franciscds/ProjetoLab3/RelatorioFinalLABPROJ03.pdf

Relatorio de Projeto - Rob ´ | o Aut ˆ | onomo ˆ

Breno Augusto Mariano, Bruno Pena Modesto e Francis Carlos Santos

I. RESUMO
Este trabalho objetiva a concepçao, construç ˜ | ao e teste de ˜
um Robo na forma de um chassi para reconhecimento da ˆ
localizaçao de blocos e sua posterior movimentaç ˜ | ao para ˜
outra determinada regiao. O principal desafio deste projeto ˜ | é
implementar um software necessario para que um rob ´ | o possa ˆ
ser capaz de receber informaçoes de sua localizaç ˜ | ao e de ˜
obstaculos via ´ | bluetooth e desempenhar algumas tarefas pre-´
estabelecidas a partir das informaçoes recebidas. ˜

II. INTRODUÇ AÕ

Durante a disciplina de Laboratorio de Projetos 3 foi pro- ´
posto a elaboraçao de um projeto para a criaç ˜ | ao de um rob ˜ | ô
que moveria alguns corpos (blocos) para regioes previamente ˜
especificadas. Para realizar tal missao, ˜ | e necess ´ | ario um soft- ´
ware adequado para que o robo possa desempenhar essas ati- ˆ vidades. O software desenvolvido possui uma parte destinada
as configuraçoes de comunicaç ˜ | ao fornecidas pelo professor, ˜
uma parte para teste da comunicaçao via ˜ | bluetooth e uma
parte destinada ao controle do robo durante seu deslocamento. ˆ
Na seçao Materiais e M ˜ | etodos ser ´ | a mostrado os materiais ´
que foram utilizados no projeto. Nas seçoes de Projeto da ˜ Parte de Software para Comunicaçao e Projeto da Parte de ˜
Software para Controle serao descritas e detalhadas as decis ˜ | oes ˜
de implementaçao que foram tomadas no projeto havendo uma ˜
discussao e justificativa sobre o porqu ˜ | e de cada escolha ter ˆ
sido realizada. As motivaçoes que iniciaram esse estudo sobre ˜
essa tecnologia de veículos autonomos s ˆ | ao expostas a seguir. ˜
A principal vantagem dos carros autonomos ˆ | e justamente de ´
nao cometerem os mesmos erros de um condutor humano, ˜
tais quais: conduçao ego ˜ | ísta, lentidao de reflexos, violaç ˜ | ao de ˜
normas de segurança, sono e embriaguez. Os carros autonomos ˆ podem inclusive superar o reflexo normal humano, prevendo
provaveis acidentes em sua trajet ´ | | oria []c2. Plataformas de ´
transporte de pessoas em veículos privados, como a Uber, naõ funcionam com um frota de veículos de forma contínua devido
a limitaçao humana do condutor. Com ve ˜ | ículos autonomos, ˆ
uma menor frota de carros poderia atender de igual forma
o mesmo numero de usu ´ | arios do aplicativo, sem que seja ´
necessario ter gastos adicionais por trabalho noturno ou du- ´ rante finais de semana e feriados. Alem disso, outro ponto ´
interessante ao usuario ´ | e a quest ´ | ao da privacidade, j ˜ | a que ´
ao se retirar o condutor humano do veículo, o cliente poderá
sentir-se mais confortavel durante seu transporte. H ´ | a tamb ´ | em´
o fator de melhoria de segurança do serviço, pois conforme testes realizados pelo Google em seus veículos autonomos ˆ []c1, o fator humano pode ser considerado como a principal causa de acidentes envolvendo carros autonomos; por exemplo, ˆ houveram acidentes principalmente por culpa de condutores humanos de outros veículos convencionais []c3.

III. MATERIAIS E METODOS ´

Todos os materiais utilizados ao longo do projeto foram listados abaixo. Lista de Materiais:
- 1 Protoboard;
- 2 conjuntos (Roda de Traçao + Motor); ˜
- 1 Modulo Receptor Bluetooth; ´
- 1 Arduíno Uno;
- 1 Roda Boba;
- 1 Ponte H;
- Palitos de madeira e cola;
- 1 Bateria 9V;
- 2 Leds vermelho;
- 2 Resistores de 150 ohm, 330 ohm e 660 ohm;
- Software de Programaçao Arduino; ˜
- Aplicativo Android Bluetooth SPP Pro.

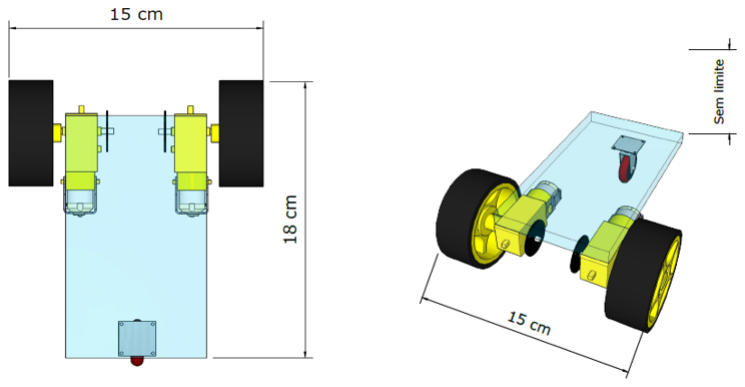
[picture p1: figure]

Figura 1: desenho inicial do robo e suas dimens ˆ | oes m ˜ | aximas ´
permitidas

Especificaçao dos Motores e das Rodas: ˜
- Tensao de Operaç ˜ | ao: 3-6 V; ˜
- Taxa de Reduçao 48:1; ˜
- Peso:30 gramas;
- Corrente sem carga: ate 200 mA(6V) e at ´ | e 150 mA(3V); ´
- Velocidade sem carga: 200 RPM (6V) e 90 RPM (3V);
- Diametro: 6.8 cm ; ˆ
- Largura: 2.6 cm;
- Furo central: 5.3 x 3.66 mm (semi-círculo);
- Peso:50 gramas.
| IV. PROJETO PARTE MECANICA E ˆ | ELETRONICA ˆ
Na figura Figura 2 ha a estrutura principal do rob ´ | o, feita de ˆ
palitos de madeira. Ha dois conjuntos roda e motor el ´ | etrico, ´
alem de uma roda boba na parte frontal do chassi dando ao ´
robo estabilidade lateral. Na parte superior est ˆ | ao alocados os ˜
demais componentes especificados na lista de materiais. Eles
serao respons ˜ | aveis pelo controle do rob ´ | o juntamente com a ˆ
funçao de comunicaç ˜ | ao dos dados de operaç ˜ | ao do rob ˜ | o. Ser ˆ | á
utilizado um padrao de identificaç ˜ | ao via ˜ | Bluetooth (QR code)

na parte superior dos blocos e do robo. Um sistema exterior ˆ
e de responsabilidade do Cliente fara a leitura da localizaç ´ | aõ
atual do bloco e das coordenadas de sua alocaçao futura, trans- ˜
mitindo tais informaçoes para o rob ˜ | o. O sistema embarcado do ˆ
robo interpretar ˆ | a os dados recebidos e controlar ´ | a o rob ´ | o para ˆ
realizar a movimentaçao. A explicaç ˜ | ao detalhada da funç ˜ | ao de ˜
cada componente esta presente na seç ´ | ao de projeto mec ˜ | anico ˆ
e eletronico desse relat ˆ | orio. A ideia inicial de desenho do rob ´ | ô
foi baseada na proposta mostrada pelo Professor-Orientador, a qual encontra-se na figura Figura 1 , juntamente com suas dimensoes m ˜ aximas permitidas. ´
V. PROJETO DA PARTE MECANICA ˆ
O desenho do robo em uma vista isom ˆ | etrica para uma ´
melhor perspectiva e mostrado na figura Figura 2, todos os de- ´ senhos foram feitos na plataforma SketchUp, para atender uma
restriçao de projeto de utilizaç ˜ | ao de ferramentas e plataformas ˜
abertas: O objetivo principal que norteou o novo desenho do

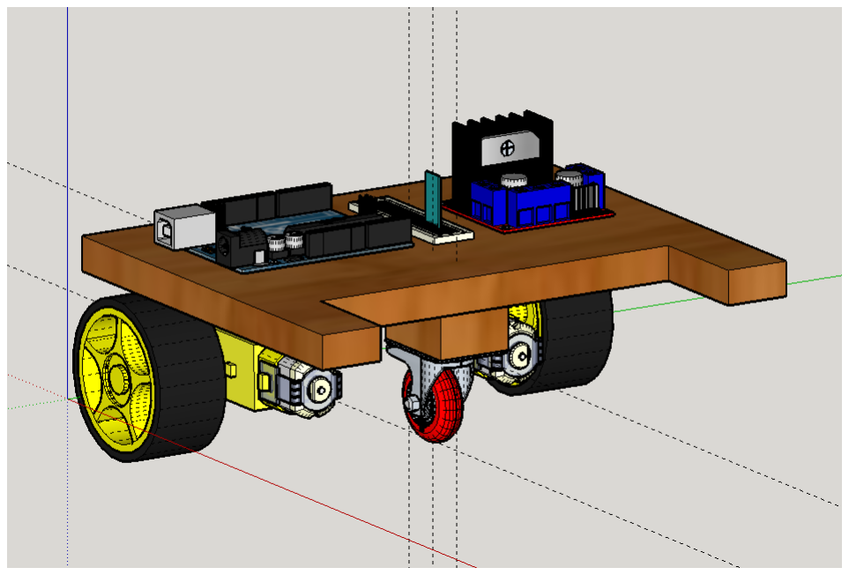
[picture p2: figure]

Figura 2: Vista isometrica do rob ´ | ô
chassi proposto foi a estabilizaçao e posterior movimentaç ˜ | aõ
do bloco, para isso foi criada duas “garras” na parte frontal do chassi, entre as quais serao alocados os blocos e em seguida ˜
sera iniciado a sua operaç ´ | ao de movimentaç ˜ | ao. O tamanho ˜
das garras foi projetado para se manter o centro de massa, e consequentemente o centro geometrico ( considerando que ´
o bloco e uniforme, esses dois pontos s ´ | | ao coincidentes) do ˜
bloco estavel durante o seu deslocamento. ´ | E preciso ressaltar ´
que os fios eletricos ir ´ | ao contornar o chassi e ser ˜ | ao fixados ˜
com adesivos para nao haver qualquer tipo de deslocamento ˜
dos mesmos, podendo atrapalhar a dinamica de movimentaç ˆ | aõ
do robo. A soluç ˆ | ao inicial de perfuraç ˜ | ao de um orif ˜ | ício
no chassi principal do robo foi descatada tendo em vista a ˆ
manutençao da estrutura inicial do chassi do rob ˜ | o, j ˆ a que uma ´
perfuraçao acarretaria no surgimento de pontos concentradores ˜ de tensao, os quais poderiam evoluir para trincas ou micro- ˜ rupturas, danificando a estrutura do chassi; alem do fato ´
de a soluçao adotada ser de implementaç ˜ | ao mais simples. ˜
Conforme e poss ´ | ível averiguar na Figura 1 que mostra os
tamanhos maximos estabelecidos para o rob ´ | o, somente duas ˆ
dimensoes foram limitadas. Assim, a terceira dimens ˜ | ao (altura ˜
do robo) foi utilizada para alocar todos os componentes. A ˆ figura Figura 3 com melhor detalhes a disposiçao das rodas ˜
do robo. Baseado na estrat ˆ | egia de utilizaç ´ | ao da dimens ˜ | ao n ˜ | ao- ˜

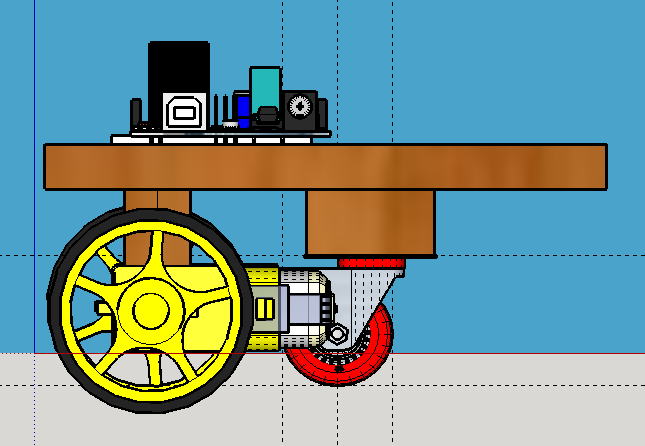
[picture p3: figure]

Figura 3: vista lateral do robo com destaque para as rodas ˆ

limitada do robo, optou-se pela colocaç ˆ | ao de suportes fixados ˜
nos motores para aumentar a altura do chassi principal em
relaçaõ as rodas de traç ` | ao (rodas amarelas), impedindo que ˜
haja contato físico entre o chassi e essas rodas, o que poderia danificar o chassi, prejudicar a rotaçao das rodas e impedir o ˜
funcionamento correto do robo. Foi adicionado tamb ˆ | em um ´
suporte para a roda boba, de forma a nivelar o chassi.

VI. PARTE ELETRONICA ˆ

Sera usada uma bateria de 9V para alimentar o circuito. A ´ bateria foi selecionada por ser mais compacta para a monta-
gem; alem de os participantes do projetos j ´ | a possu ´ | írem e terem
conhecimento previo sobre esse componente. Uma ligaç ´ | | ao em ˜
paralelo sera feita para utilizar a mesma bateria, alimentando ´ ambos os componentes. Embora o arduíno necessite de 5V de
tensao na entrada, o circuito ˜ | e preparado internamente com ´
um divisor de tensao, ou seja, qualquer tens ˜ | ao al ˜ | em dos 5V ´
sera dissipada. A Figura 4 mostra o esquema de ligaç ´ | | ao dos ˜
componentes eletronicos. ˆ

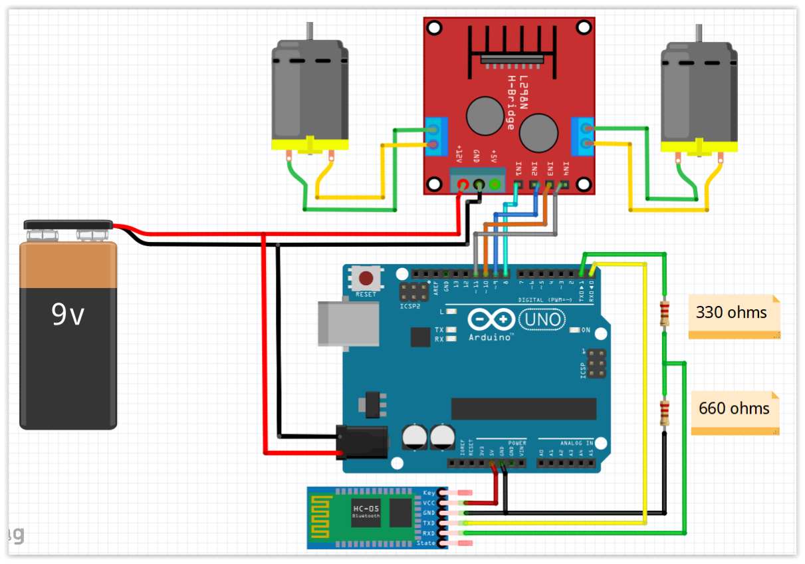
[picture p4: figure]

Figura 4: Esquematico de montagem dos componentes ´
eletronicos b ˆ | asicos do carrinho ´

A seguir descreve-se a disposiçao proposta dos componentes ˜
e o motivo de sua utilizaçao. A ponte H (Figura 5) ˜ | e um ´
circuito que permite realizar a inversao da polaridade da ˜
corrente que flui atraves de uma carga, por isso ´ | e interessante ´
para controlar os motores DC.

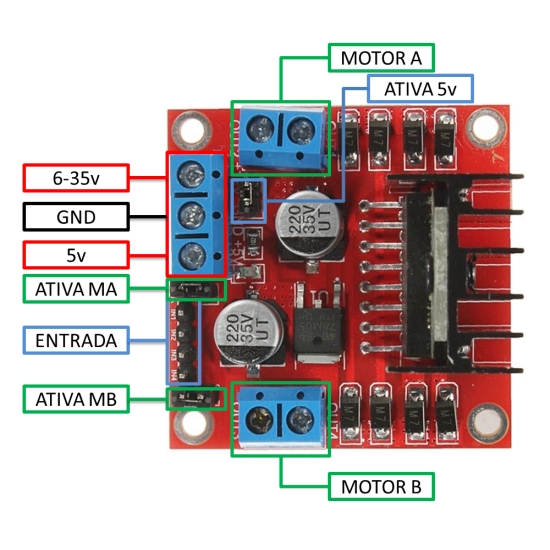
[picture p5: figure]

Figura 5: Ponte H com indicaçao de pinos ˜

A Figura 5, mostra a ponte H e suas entradas. A ponte H pode ser alimentada de 2 formas, com tensao de 5V, no caso ˜
de ligaçao direta do arduino e ˜ | 6-35V para alimentaçao externa. ˜
Para utilizar a alimentaçao de 5V, o jumper em ˜ | Ativa 5V deve
ser removido para configurar uma referencia na entrada de ˆ | 6-
35V. Ativa MA corresponde ao motor A e Ativa MB a ativaç ` | aõ
do nível logico para o ´ | motor B, para nosso projeto nenhum
jumper foi removido. O arduíno foi o micro-controlador escolhido, o qual transmitira para as rodas as coordenadas que ´
serao informadas pelo dispositivo ˜ | bluetooth. O arduíno passará
instruçoes para os motores por meio das entradas ˜ | PWM (
modelagem por largura de pulso) de numeros 4,5,6 7, 2 e ´
3. As portas 4,5,6 e 7 serao utilizadas para dar sentido para ˜
o movimento e as portas 2 e 3 serao a alimentaç ˜ | aõ PWM na
entrada de enable na ponte H dessa forma variando a tensaõ
de ativaçao das rodas simulando v ˜ | arios ´ | pings de 0 a 5 volts.
A utilizaçao das portas ˜ | PWM possibilita que a velocidade de
rotaçao dos motores seja controlada e n ˜ | ao uma constante. O ˜
Arduíno Uno foi escolhido por sua implementaçao ser mais ˜ simples, por exemplo a possibilidade de se realizar a sua carga
diretamente do computador e tambem pela experi ´ | encia pr ˆ | evia ´
dos participantes do projeto com tal dispositivo.
O modulo ´ | Bluetooth escolhido foi o modelo HC-06 que
possui 4 pinos (alimentaçao, ˜ | GND,RX e TX). Os dois ultimos ´
sao utilizados para comunicaç ˜ | ao com o micro-controlador ˜
via serial. O nível logico dos pinos ´ | RX e TX e 3.3V, logo ´
precisamos de um divisor de tensao no pino ˜ | RX para que
esse nao seja danificado. Esses pinos ser ˜ | ao ligados na entrada ˜
serial do Arduino Uno que possui um par 0(RX) e 1(TX).
A utilizaçao do m ˜ | odulo ´ | Bluetooth deve-se ao processo de
recebimento das coordenadas de localizaçao do rob ˜ | o atrav ˆ | es´
de um marcador QR-code, esse sinal sera transmintido atrav ´ | es´
de um dispositivo bluetooth. O modelo HC-06 foi escolhido
por ter a implementaçao mais simples, a sua desvantagem ˜ | é
a restriçao em somente receber dados. O ardu ˜ | íno foi ligado
em paralelo a bateria de 9V. O nível logico do arduino ´ | e de ´
5V e a sua capacidade de entrada e de 3.3V, para n ´ | ao haver ˜
nenhum dano foi montado um divisor de tensao utilizando dois ˜
resistores, projetando uma tensao m ˜ | axima de 3.3V no pino ´ | RX.

VII. PROJETO DA PARTE DE SOFTWARE PARA COMUNICAÇ AÕ
A parte de software estabelecida para o projeto consiste de 3 codigos que foram utilizados para fazer um teste inicial de ´
comunicaçao via ˜ | bluetooth com smartphone, outro para testar
a recepçao dos dados recebidos do sistema de localizaç ˜ | | | | | | | ao e por ˜
ultimo um c ´ | odigo respons ´ | avel para receber e tratar os dados ´
recebidos para serem utilizados para o controle do carrinho.
Em todos os codigos, dentro do procedimento ´ | setup, e definido ´
inicialmente uma comunicaçao serial via ˜ | bluetooth e atraves´
de quais pinos do arduíno ela ocorre. Em todos os codigos ´ a comunicaçaõ bluetooth recebeu o nome de mySerial. Para
implementaçao do c ˜ | odigo foi utilizado o software do ardu ´ | íno,
escrito predominantemente em C++.
Apos | a | configuraç ´ | ao | do | m ˜ | odulo ´ | bluetooth | para
comunicaçao, foi implementado um c ˜ | odigo para testar a ´
comunicaçao. Esse c ˜ | odigo realiza inicialmente um comando ´
(if(mySerial.available() > 0)) para verificar se a comunicaçaõ bluetooth esta estabelecida, depois de o ser teste realizado, foi ´ utilizado o aplicativo android Bluetooth SPP Pro para enviar as letras A e B para o arduíno, dependendo da letra recebida, um led era aceso e em caso de outra letra recebida, outro led era aceso e nos dois casos uma mensagem de confirmaçaõ era retornada para o smartphone.
O codigo utilizado para testar o recebimento dos dados en- ´ viados pelo sistema e verificar o formato dos dados recebidos,
faz um teste inicial da comunicaçao atrav ˜ | es dos comandos ´
if(mySerial.available() > 0) e if(Serial.available() > 0)), para verificar sua integridade, caso a comunicaçao esteja ˜ estabelecida, as mensagens recebidas do sistema de localizaçaõ
via bluetooth sao passadas para o ardu ˜ | íno atraves do comando ´
(mySerial.write(Serial.read()) que esta dentro do ´ | if que avalia
a comunicaçao serial) s ˜ | ao escritas na sa ˜ | ída (monitor serial do
arduíno) utilizando o comando (Serial.write(mySerial.read())
que esta dentro do if que avalia a comunicaç ´ | aõ mySerial),
os dados sao mostrados conforme recebidos, sem nenhum ˜ tratamento.
A parte de recebimento e manipulaçao da informaç ˜ | ao, ˜
basicamente (em alto nível) armazena a mensagem recebida,
caracter por car ´ | acter, e depois separa a informaç ´ | ao de acordo ˜
com o seu destino. Assim, caso a mensagem se refira ao nosso carrinho (letra C como identificador), sua posiçao nos ˜
eixos cartesianos x-y e o angulo em relaç ˆ | ao a refer ˜ | encia ˆ
serao salvos em tr ˜ | es vari ˆ | aveis. Caso a mensagem se refira ´
a algum outro carrinho ou obstaculo (letras A, B, D ou E), ´
as informaçoes ser ˜ | ao armazenadas em outras tr ˜ | es vari ˆ | aveis. ´
A tarefa desempenhada por esse codigo pode ser melhor ´ representada por um fluxograma, conforme Figura 6 abaixo:

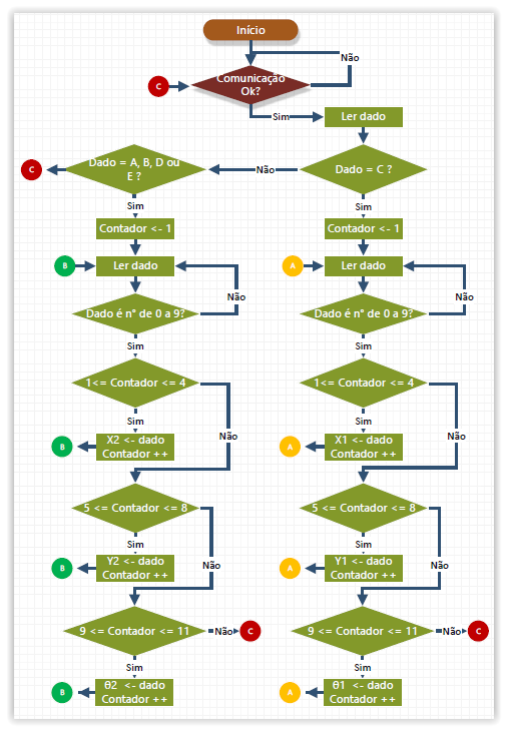
[picture p6: figure]

Figura 6: Fluxograma de Recepçao dos Dados ˜

Na Figura 6 as variaveis X ´ | 1, Y1, X2 e Y2 sao vetores de ˜
tamanho 4 e as variaveis ´ | | θ1 e θ2 sao vetores de tamanho 3. ˜
Os dados recebidos sao do tipo ˜ | char e sao manipulados dessa ˜
forma, apos a separaç ´ | ao eles s ˜ | ao convertidos para inteiro para ˜
que sejam utilizados em calculos matem ´ | aticos. O fluxograma ´
mostra como e feito o recebimento e manipulaç ´ | ao para dois ˜
marcadores (carrinhos ou obstaculos), caso em uma aplicaç ´ | aõ
exista mais marcadores, o mesmo codigo implementado base- ´ ado no fluxograma pode ser reutilizado com poucas alteraçoes, ˜
incluindo novas variaveis X’n°’, Y’n°’ e ´ | θ’n°’ para cada
marcador adicional.

VIII. PROJETO DA PARTE DE SOFTWARE PARA CONTROLE

A. Príncipios físicos e modelagem
A definiçao do modelo cinem ˜ | atico ´ | e de extrema import ´ | ancia ˆ
para a definiçao do sistema de controle. Pois ele determina as ˜
equaçoes que conduzem a din ˜ | amica de movimentaç ˆ | ao do rob ˜ | o. ˆ
Na figura Figura 7 pode-se observar esse modelo.
Esse modelo pode ser representado, pelas seguintes equaçoes: ˜

dx
dt =
| Ve + Vd | cosθ

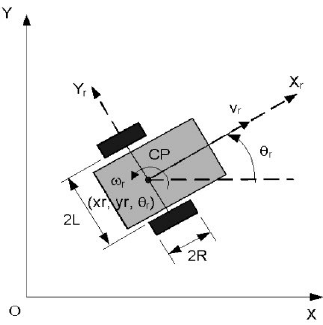
[picture p7: figure]

Figura 7: Modelo cinem´ atico do Modelo ´

dy
dt =

Ve + Vd
2

sinθ

dθ
dt =

Ve − Vd
2
A distancia de refer ˆ | encia para partida ser ˆ | a calculada atrav ´ | es´
da formula de dist ´ | ancia Euclidiana mostrada abaixo: ˆ
| d =

p
| (xk+1 − x) | 2 + (yk+1 − y)

2

B. Projeto de Controlador
O controlador foi implementado utilizando a logica ´ fuzzy. O controlador fuzzy pode controlar a navegaçao e evitar, ˜
simultaneamente, os obstaculos. A estrutura b ´ | asica do pro- ´
jeto contem tr ´ | es partes principais: fuzzificaç ˆ | ao, infer ˜ | encia e ˆ
desfuzzificaçao. A primeira etapa ˜ | e a fuzzificaç ´ | ao que trans- ˜
forma os dados de entrada reais em funçoes de pertin ˜ | encia ˆ
classificadas por magnitude. A segunda parte e a infer ´ | encia ˆ
da saída fazendo-se uma analise das entradas comparando- ´ as com as regras pre-definidas. No caso deste trabalho como ´ teremos mais de uma entrada a regra de decisao ser ˜ a do tipo: ´

IF(CONDICAO1)T HEN(CONCLUSAO)

Por ultimo ser ´ | a realizada a desfuzzificaç ´ | ao que ˜ | e o processo ´
de se retirar resultados numericos da funç ´ | ao de pertin ˜ | encia de ˆ
saída baseada nas saída da segunda etapa.
No Matlab o processo pode ser criado atraves do ´ plugin mostrado abaixo na Figura Figura 8. Porem, com o intuito ´ de desenvolver o controlador ferramentas Open Source foi decidido implementar a logica ´ fuzzy diretamente no arduino utilizando a biblioteca eFLL - Embebed Fuzzy Logic Library.

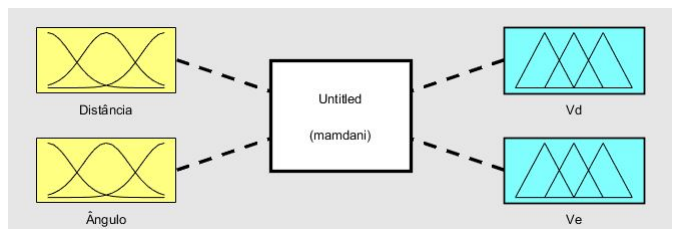
[picture p8: figure]

Figura 8: Diagrama Fuzzy

C. Biblioteca Utilizada
Para implementar a logica ´ fuzzy no arduíno, existe a biblioteca Embebed Fuzzy Logic Library sendo toda desenvolvida utilizando apenas a biblioteca stdlib.h, logo e uma biblioteca ´ que pode ser usada em qualquer sistema que suporte a linguagem C []c4. Os compomentes principais dessa biblioteca sao: ˜
- Objeto Fuzzy: Objeto que engloba todo o sistema fuzzy, com ele podemos manipular todos os conjuntos fuzzy e
suas variaveis lingu ´ | ísticas.
- Objeto | FuzzyInput: | Representaçao | da | vari ˜ | avel ´
linguística de entrada do sistema. E bastante similar a ´
variavel criada para a sa ´ | | ída do sistema.
- Objeto FuzzySet: E utilizado para a modelagem da ´
funçao de pertin ˜ | encia de uma vari ˆ | avel. As funç ´ | oes podem ˜
ser triangulares, trapezoiais e singleton.
- Objeto FuzzyOutput: Da mesma forma que o FuzzyIn-
put, este objeto agrupa varios ´ | FuzzySet e formam a funçaõ
de pertinencia de sa ˆ | ída.
- Objeto FuzzyRule: Esse objeto representa uma regra de
decisao que ser ˜ | a adicionada ao objeto ´ | fuzzy. Esse objeto
e composto por um ´ | FuzzyRuleAntecedent e um Fuzzy-
RuleConsequent. A base de conhecimento fuzzy deve, obrigatoriamente, conter um ou mais objetos FuzzyRule.
- Objeto FuzzyRuleAntecedent: Armazena a condiçao de ˜ ativaçao de uma regra. ˜
- Objeto FuzzyRuleConsequent: Armazena o resultado se a regra for ativada.
D. Implementaçaõ
Com a utilizaçao da biblioteca ˜ | eFLL a implementaçaõ
e simplificada. O que torna a manutenç ´ | ao do c ˜ | odigo ´
simples, se o mesmo for funcional, e facilita a inclusaõ de novas funcionalidades assim como a adicionar novas entradas e saídas. O primeiro passo da implementaçaõ
e a criaç ´ | ao do objeto ˜ | fuzzy que armazenara todos os ´
componentes do sistema:

F uzzy ∗ F uzzy = newF uzzy();

A instancia do objeto ˆ | fuzzy, assim como todo o processo
de criaçao da l ˜ | ogica ´ | fuzzy, devera ser implementado ´
dentro da funçao ” ˜ | void setup()”do arduíno, pois precisa
ser feito apenas uma vez na inicializaçao do sistema. ˜
Na funçaõ setup , as variaveis de entrada ”Dist ´ | ancia”e ˆ
”Angulo”s ˆ | ao criadas utilizando o objeto ˜ | FuzzyInput e
seus respectivos IDs, os quais devem ser passados como
parametros. A modelagem da vari ˆ | avel ´ | e feita utilizando- ´
se os objetos FuzzySet. O codigo abaixo mostra a ´
implementaçao da vari ˜ | avel de entrada ”distancia”. Para ´
uma modularizaçao maior, primeiro foi instaciado os ˜ FuzzySet

F uzzySet ∗ dmuitoP equena = new

F uzzySet(0, 0, 0, 125);

F uzzySet ∗ distanciaP equena = new

F uzzySet(0, 125, 125, 250);

F uzzySet ∗ distanciaMedia = new

F uzzySet(125, 250, 250, 375);

Apos a modelagem, ainda na funç ´ | aõ setup, os fuzzySets
sao incorporados ˜ | a vari ` | avel ´ | fuzzyInput distancia, como
pode ser visto abaixo.

F uzzyInput ∗ dist = newF uzzyInput(2);

dist− > addF uzzySet(distanciaMuitoP equena);

dist− > addF uzzySet(distanciaP equena);

dist− > addF uzzySet(distanciaMedia);

Finalmente, o objeto FuzzyInput e incorporado no objeto ´ fuzzy:
fuzzy− > addF uzzyInput(dist);

Os passos citados acima devem ser feitos para todas as
variaveis de entrada e sa ´ | ída do sistema. A unica diferença ´
e que para o sistema de sa ´ | ída o objeto é FuzzyOutput().
Uma vez cadastrado todas as entrada e saída do sistema,
e preciso incluir a base de regras. Na biblioteca ´ | | | | | | | eFLL a
regra e formada por uma condiç ´ | ao antecedente e por um ˜
estado que e consequ ´ | encia. Primeiramente ˆ | e importante ´
definir qual sera a regra. Nesse caso, como exemplo ´
temos: Se a distancia ˆ | e grande ´ | E o angulo ˆ | e positivo ´
pequeno ENTAÔ | a velocidade de saída na roda direita
e baixa e na roda esquerda ´ | e m´ | edia. A Regra ´ | e criada ´
da seguinte forma, primeiro e instanciado um objeto ´ FuzzyRuleAntecedent

F uzzyRuleAntecedent∗

distanciaGrandeEAnguloP P equeno = new

F uzzyRuleAntecedent();

Depois e utilizada a funç ´ | aõ joinWithAND para a operaçaõ
AND da seguinte forma:

distanciaGrandeEAnguloP P equeno

− > joinW ithAND(dmuitoP equena, pP equeno);

Em seguida, e instanciado o objeto que representar ´ | a a ´
consequencia: ˆ

F uzzyRuleConsequent∗thenV disBmAndV eZ = new

F uzzyRuleConsequent();

Feito isso precisamos incorporar essa regra a sa ` ída do sistema.

thenV disBmAndV eZ− > addOutput(vBaixad);

Ao final e criada a pr ´ | opria regra utilizando o objeto ´
FuzzyRule. Todos os passos descritos acima devem ser seguidos para criar todas a regras necessarias. ´
A | entrada | do | sistema, | fuzzificaçao, | e | sa ˜ | ída,
desfuzzificaçao, s ˜ | ao implementadas na funç ˜ | aõ | loop(),
nesse projeto os parametros de entrada, dist ˆ | ancia e ˆ
angulo seriam obtidos atrav ˆ | es de funç ´ | oes tamb ˜ | em´
codificadas para calculo do ´ | angulo a ser ajustado para ˆ

o movimento e da distancia euclidiana. Os valores de ˆ distancia iriam variar de 0 a 1000mm e deveriam ser ˆ inseridos no sistema fuzzy da seguinte forma:

fuzzy− > setInput(1, angulo);

fuzzy− > setInput(2, distanca);

Para iniciar o processo de fuzzificaçao, ˜ e utilizada a ´ funçaõ fuzzify():

fuzzy− > fuzzify();

Essa funçao faz a infer ˜ | encia baseada nos valores de ˆ
entrada de cada fuzzyInput. Para a desfuzzificaçaõ | é
necessario fazer a chamada da funç ´ | | | aõ defuzzify passando
como parametro o ˆ | ID do objeto FuzzyOutput que corres-
ponde a saída desejada.

floatv1 = F uzzy− > defuzzify(1)

Por ultimo, o valor de sa ´ | | ída, que sera entre 0 e 70, foi ´
convertido para o valor utilizado no PWM do arduíno, que e entre 0 e 255, dessa forma podemos controlar a ´ velocidade dos motores. Outro passo que deve ser feito
na funçao de ˜ | setup e a configuraç ´ | ao da porta que dever ˜ | á
ser utilizada como PWM.

pinMode(3, OUT P UT);

O valor pode ser convertido com a funçao mostrada ˜ abaixo. Essa funçao basicamente lineariza todos os valo- ˜
res com base no maximo estabelecido e ent ´ | ao multiplica ˜
pelo valor maximo que pode ser aplicado na sa ´ | | | ída PWM.
| velodidadeD = | v1
| | 70

× 255

Na saída PWM o valor pode ser aplicado da seguinte maneira:

analogW rite(3, velocidadeD);

As regras que serao utilizadas para implementaç ˜ | ao do ˜
sistema estao exemplificadas na tabela I. Os estados s ˜ | aõ
explicados abaixo:
1) Distancia ˆ d
- MP : Muito Pequena.
- P : Pequena.
- M : Medio. ´
- G : Grande.
- MG : Muito Grande.
2) Angulo de deslocamento ˆ | θ
- Z : Zero.
- PP : Positivo Pequeno.
- PM : Positivo Medio. ´
- PG : Positivo Grande.
- NP : Negativo Pequeno.
3) Velocidade
- Z : Zero.
- MB : Muito Baixa.
- B : Baixa.
- M : Media. ´
Tabela I: Indicaçao Vari ˜ | aveis ´
Distancia ˆ | Angulo | Vd | Ve ˆ
MP | Z | MB | MB
P | PP | Z | MB
M | PM | MB | B
G | PG | R | MR
MG | NP | B | MB
- R : Rapida. ´
- MR : Muito Rapido. ´
Os funçoes de pertin ˜ | encia de entrada t ˆ | em caracter ˆ | ísticas
como mostrados na figura Figura 9 e figura Figura 10

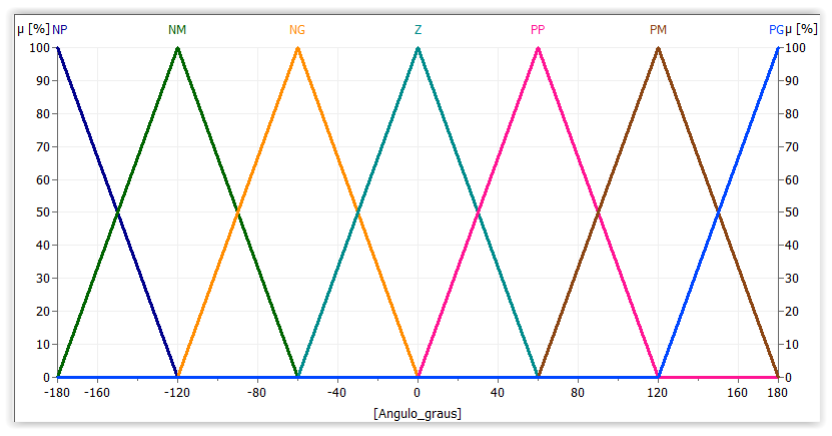
[picture p9: figure]

Figura 9: Funçao de pertin ˜ | encia para o ˆ | angulo. ˆ

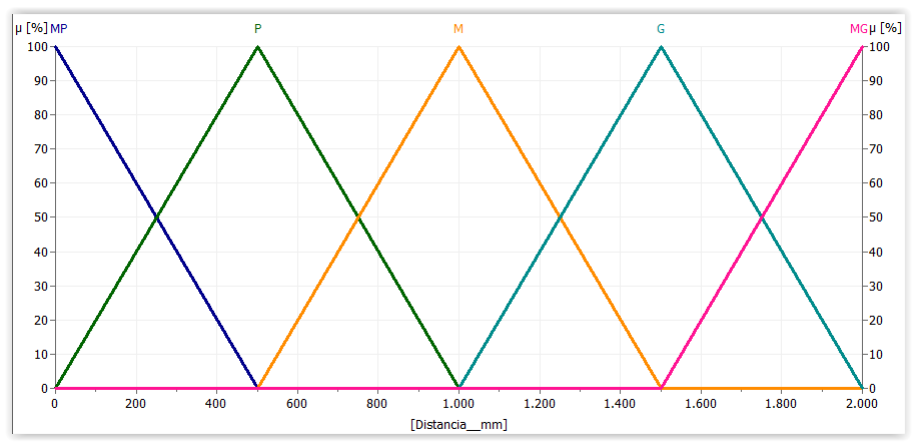
[picture p10: figure]

Figura 10: Funçao de pertin ˜ | encia para a dist ˆ | ancia. ˆ
E. Decisoes de Implementaç ˜ | aõ
O software de controle ira basicamente definir qual a ´ velocidade de cada roda, ou seja, a velocidade de rotaçaõ
de cada motor DC. As velocidades sao definidas como ˜ | Vd
e Ve sendo respectivamente as velocidades de rotaçao das ˜ rodas direita e esquerda. O projeto de controle foi dividido em duas fases. Na primeira fase, o deslocamento do destino ate a ´
origem. Na segunda fase, o robo realizar ˆ | | a o trajeto proposto ´
evitando obstaculos. Em resumo: ´
- Fase 1: Deslocamento Simples;
- Fase 2: Deslocamento com desvio de obstaculos; ´
As variaveis utilizadas na soluç ´ | ao ser ˜ | ao basicamente as ˜
mostradas na tabela II

IX. FUZZY LOGIC CONTROLLER X CONTROLE CLASSICO ´

Durante o desenvolvimento do trabalho dificuldades foram encontradas para debugar o codigo quando os resultados ´ apresentados eram resultados nao esperados. O controlador ˜ de logica ´ fuzzy foi escolhido para resolver o problema devido a proximidade das regras de decisao com a linguagem ˜

Tabela II: Variaveis de controle ´

Parametros ˆ
d | Distancia ˆ
θ | Angulo de deslocamento ˆ
Vd, Ve | Velocidade
X,Y | Coordenadas de Origem
x,y | Coordenadas de Destino
xo, yo | Coordenadas do Obstaculo ´
natural. Uma outra soluçao seria a implementaç ˜ | ao de um ˜
controlador proporcional integrativo derivativo (PID),esses tresˆ componentes sao variados para se obter uma resposta ideal. O ˜ controlador PID e um dos mais usados devido a sua simpli- ´ cidade. O controlador baseado em logica ´ fuzzy tem diversas ˆ vantagens, mas apresenta tambem muitos pontos negativos que ´ serao citados a seguir. Dentre as vantagens mais importantes ˜ da logica Fuzzy pode-se citar: ´
- Flexível e a base de conhecimento construída para o controle e bastante intuitiva pois as regras de controle ´ sao facilmente entendidas na linguagem normal. ˜
- Conveniente para o usuario final, ´ | e simples para o usu ´ | ario ´
final identificar as regras e suas consequencias. ˆ
- A logica fuzzy ´ | e simples de ser implementada computa- ´
cionalmente.
- Facil de validar e verificar as regras de sa ´ | ude, uma ´
vez que o sistema seja funcional. Isso facilita nos casos onde a logica ´ fuzzy sera utilizada juntamente com algum ´ algoritmo de aprendizado de maquina. ´
- fuzzy e uma forma n ´ | ao amb ˜ | ígua de representar uma
informaçao incerta na forma de linguagem natural. ˜
Apesar de parecer ser aplicavel em in ´ | umeros cen ´ | arios e ser ´
a soluçao perfeita em v ˜ | arios casos, a l ´ | ogica fuzzy apresenta ´
tambem alguns pontos negativos. Abaixo s ´ | ao citados alguns: ˜
- A sintonizaçao da regras de decis ˜ | ao devem ser feitas ˜
manualmente, o que aumenta o tempo necessario para ´ o desenvolvimento.
- Naõ e necessariamente melhor que um controle PID, que ´ e mais simples de ser implementado. ´
- Em algumas situaçoes, a relaç ˜ | ao robustez-performance ˜
naõ e considerada na sintonizaç ´ | ao do controlador ˜ | fuzzy.
Geralmente assume-se que a robustez e uma propriedade ´ fundamental do controlador fuzzy, o que naõ e verdade, ´ uma vez que se for mal sintonizado as regras podem naõ avaliar todo o domínio da planta.
- Em alguns casos, as regras de decisao s ˜ ao equivalentes a ˜ pesquisar o resultado em uma matriz de decisao. ˜
- Se a dimensao do problema for muito grande ˜ | e pratica- ´
mente impossível de se implementar todas as regras de decisao, o que torna a dimensionalidade uma das maiores ˜
restriçoes do Controlador de L ˜ | ogica ´ | fuzzy []c6.
O sistema de controle desejado nesse trabalho era, de certa forma, simples. Tardiamente foi constatado que a logica ´ fuzzy pode ser entendida como uma soluçao muito complexa para o ˜ desafio proposto. A falta de sucesso no projeto, pode ser res-
saltada tambem para evidenciar a dificuldade da identificaç ´ | aõ
de problemas com a logica ´ | fuzzy, ja que por ser muito pr ´ | oxima ´
da linguagem natural e dif ´ | ícil de entender onde esta localizado ´
o erro. Para trabalho, a utilizaçao de uma biblioteca em uma ˜ linguagem mais baixo nível, torna o processo mais lento, pois
se trabalha com a construçao manual das curvas e n ˜ | ao com ˜
uma interface grafica, como seria se tivesse sido utilizado o ´ MATLAB.
A. Resultados Experimentais e Simulaçoes do Controlador ˜
Apos finalizar a implementaç ´ | ao do controlador, testes foram ˜
feitos para averiguar se o sistema respondia adequadamente para determinadas entradas e saídas. Foi observado entao que ˜
a velocidade de saída nao era suficiente para a alimentaç ˜ | ao do ˜
da porta PWM. Para entender melhor o como as regras estavam atuando, as regras foram simuladas utilizando a funçaõ fuzzy no MATLAB. Na Figura Figura 11 mostramos o diagrama de
regras de decisao para a seguinte entrada: dist ˜ | ancia igual a ˆ
364mm e angulo a ser ajustado igual a 70 graus. Podemos ˆ observar que a velocidade de saída e baixa, como esperado, ´
pois o robo estaria fazendo o ajuste do ˆ | angulo para o mo- ˆ
vimento. A Velocidade de saída na roda direita e 17,9mm/s ´ e 33,9mm/s na roda esquerda. O que colocado na formula ´
mostrada os da um 25% de 255 e 48% de 255 na outra (255 ´ | e o ´
maxímo valor que pode ser colocado na saída PWM). Como o
controlador implementado naõ e integrador, ou seja n ´ | ao existe ˜
uma previsao do caminho incialmente traçado e portanto torna ˜ muito difícil simular um caminho qualquer com o robo.ˆ

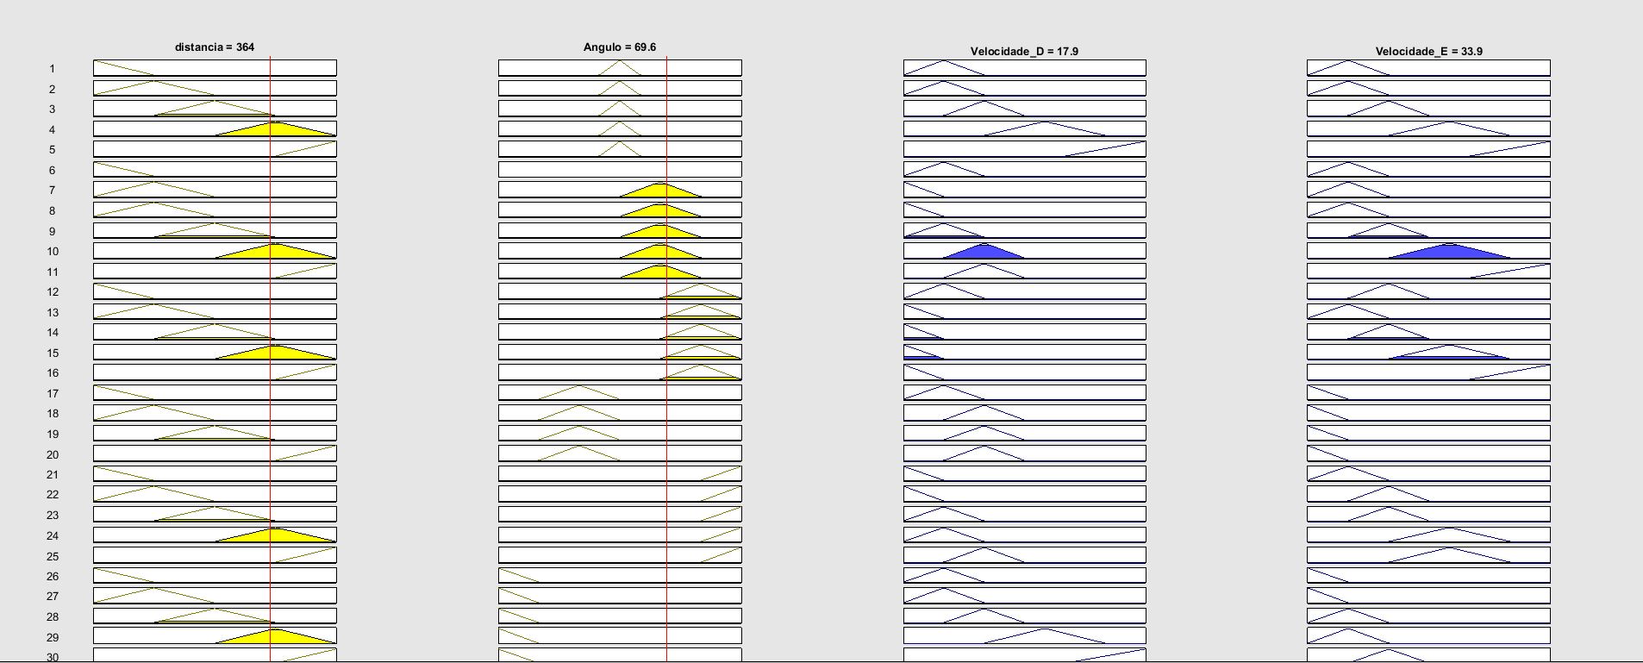
[picture p11: figure]

Figura 11: Regras de decisao do controlador plotadas no ˜ MATLAB

Na Figura Figura 12 e poss ´ ível observar a saída comentada acima na saída serial do arduino como mostrada na simulaçaõ mostrada no MATLAB.

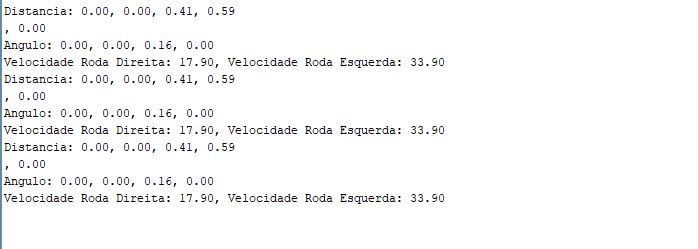
[picture p12: figure]

Figura 12: Resultados da simulaçao de controle para ˜ entradas: Distancia = 324 e Angulo = 69.3

X. RESULTADOS EXPERIMENTAIS E SIMULAÇ OES DA ˜ COMUNICAÇ AÕ

Para o teste de comunicaçao inicial foi implementado um ˜ circuito utilizando 2 leds vermelhos e 2 resistores de 150 ohms.

Quando a letra ”A”e recebida do smarthphone o ´ | led 1 e aceso e ´
uma mensagem, ”LED 1 ligado !”, e retornada para o telefone, ´
caso a letra ”B”e recebida o ´ | led 2 e aceso e a mensagem de ´
confirmaçaõ e, ”LED 2 ligado !”. O teste foi realizado diversas ´ vezes e apresentou resultado satisfatorio em todas elas. ´
No teste para recepçao e verificaç ˜ | ao do formato das men- ˜
sagens recebidas, o sistema de localizaçao enviou centenas de ˜ mensagens e todas foram recebidas corretamente. A seguir na Figura 13 e mostrado algumas mensagens recebidas: ´

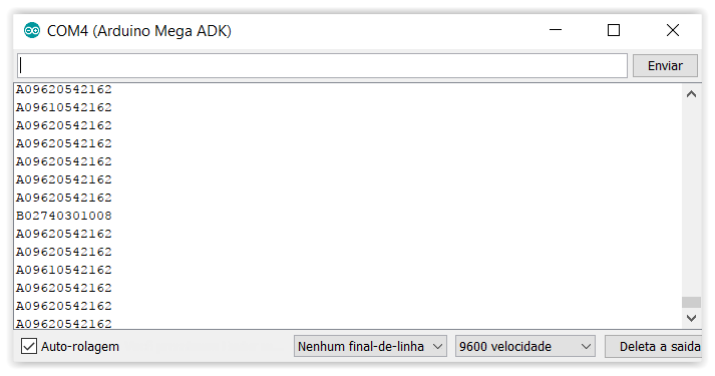
[picture p13: figure]

Figura 13: Mensagens recebidas do sistema de localizaçaõ

Para testar a parte do codigo referente ´ | a recepç ` | ao e ˜
manipulaçao dos dados, foram utilizadas v ˜ | arias mensagens em ´
sequencia com o mesmo formato do protocolo de comunicaç ˆ | aõ
(recebidas do sistema em outro momento): 1 letra para identificar o marcador seguida de 11 caracteres, sendo 4 para cada
eixo de referencia, 3 para o ˆ | angulo e 1 car ˆ | acter de mudança ´
de linha. Essas mensagens foram enviadas do computador para o arduíno nas taxas de 9600, 38400 e 115200 bps. Para
simulaçao foi inclu ˜ | ído no codigo proposto duas vari ´ | aveis para ´
contabilizar o numero de mensagens recebidas e destinadas ´ para um identificador e para o outro identificador e comandos
para apresentaçao do valor dessas vari ˜ | aveis no monitor serial. ´
Na taxa de 38400 bps foram enviadas 200 mensagens, sendo 100 para cada identificador, o procedimento foi repetido 5 vezes, sendo que em media 88,8% das mensagens foram ´ recebidas e processadas pelo arduíno. Para as taxas de 9600 e 115200 bps foi repetido o procedimento, onde 89% e 91,9% em media das mensagens foram recebidas, respectivamente. ´

XI. CONCLUSOES ˜

Durante a primeira parte do projeto foi realizada uma
analise macro dos objetivos, requisitos e tarefas necess ´ | arias ´
para se atingir o produto final desejado. Havendo a criaçaõ de diferentes desenhos e soluçoes para o problema proposto. ˜ Tres fatores principais nortearam a escolha do desenho final ˆ e da disposiçao dos componentes. Primeiramente o custo ˜ dos materiais, optou-se por associar confiabilidade com o preço acessível dos componentes; outro fator importante foi o objetivo do cliente, o qual tinha que estar submetido a algumas
restriçoes de projeto j ˜ | a citadas; e o ´ | ultimo fator importante ´
para a parte mecanica foi a estabilidade, agilidade e resist ˆ | encia ˆ
do robo. Nas etapas de construç ˆ | ao e implementaç ˜ | ao da parte ˜
mecanica e eletr ˆ | onica desse projeto n ˆ | ao houveram problemas ˜
significativos.
Na fase de implementaçao de software e testes para ˜
comunicaçao n ˜ | ao foi poss ˜ | ível verificar se a manipulaçao dos ˜

dados estava sendo realizada de forma correta. Isso ocorreu
devido a nao realizaç ˜ | ao de simulaç ˜ | oes com o objetivo de ˜
validar essa funcionalidade do codigo, j ´ | a que a comunicaç ´ | aõ
estava funcionando corretamente. Assim, nao foi constatada ˜ a efetividade dessa funcionalidade e alteraçoes foram imple- ˜
mentadas no codigo para que o resultado da manipulaç ´ | aõ
fosse apresentado no monitor serial da IDE do arduíno.
Porem isso n ´ | ao realizado em tempo h ˜ | abil, caso a simulaç ´ | aõ
da comunicaçao entre computador e arduino fosse realizada ˜ previamente, nao haveria sido demandado longo tempo com ˜ uma medida paliativa, a qual se mostrou ineficiente. Apos´
a apresentaçao do trabalho foi realizado a simulaç ˜ | ao apre- ˜
sentada na sessao e foi observado que o c ˜ | odigo proposto ´
provavelmente seria capaz de realizar a tarefa de manipulaçaõ
dos dados, ou seja, nao seria necess ˜ | ario realizar a validaç ´ | aõ
utilizando o sistema de localizaçao como foi tentado e n ˜ | ao deu ˜
certo. Apesar dos equívocos nesta parte, pode-se obter o apren-
dizado de que e preciso definir de forma pr ´ | evia e clara quais ´
os testes e os resultados necessarios para validaç ´ | ao parcial de ˜
uma etapa do projeto, bem como medidas alternativas em caso
da nao possibilidade de realizaç ˜ | ao ou resultado insatisfat ˜ | orio ´
dos testes.
A implementaçao do sistema de controle foi desafiadora ˜ e nesse trabalho foi apresentada apenas uma alternativa de
implementaçao. ˜ | E importante deixar claro que os m ´ | etodos ´
acima descritos foram verificados separadamente e portanto
nao foi poss ˜ | ível verificar o funcionamento do sistema como
um todo. Os proximos passos ser ´ | ao a implementaç ˜ | ao completa ˜
das duas fases e testes. Um dos pontos a ser melhor trabalhado
em projetos futuros e o caracterizaç ´ | ao mais completa do ˜
projeto, com a criaçao e determinaç ˜ | ao de sub-tarefas e sub- ˜
objetivos dentro do escorpo principal do projeto, facilitando a soluçao dos problemas que surgirem ao longo do projeto e ˜ detalhando melhor a abordagem do problema principal.

REFERENCIAS ˆ

[1] https://tecnoblog.net/178274/carros-autonomos-google-ruas-california. Acesso em 07/12/2017.
[2] https://g1.globo.com/carros/noticia/rival-do-uber-faz-testes-comclientes-em-carros-autonomos-nos-eua.ghtml. Acesso em 07/12/2017.
[3] http://irisbh.com.br/carros-autonomos-desafios-e-perspectivas . Acesso em 07/12/2017.
[4] eFLL | - | Embebed | Fuzzy | Logic | Library. | Disponível | em
github.com/zerokol/eFLL. Acessado em 10 de Outubro de 2017.
[5] http://www1.folha.uol.com.br/mercado/2017/11/1936747-uber-planeja-
comprar-24-mil-carros-autonomos-da-volvo.shtml. | Acesso | em
07/12/2017.
[6] Albertos, Pedro, and Antonio Sala. ”Fuzzy logic controllers. Advantages and drawbacks.”VIII International Congress of Automatic Control. Vol.
3. 1998.
